Keyboard-PCB-Replica-Project/Cloudnine_rp2040/Cloudnine_rp2040.step

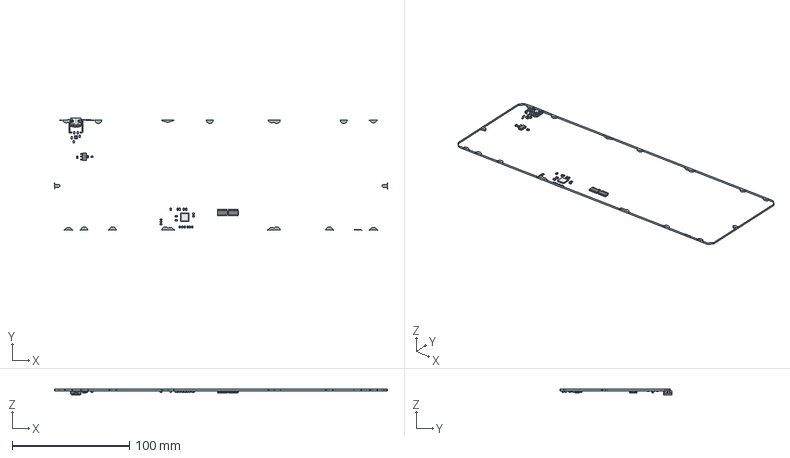
[picture p1: CAD file, 2025-07-11]
Cloudnine_rp2040.step
284.3 x 95.7 x 4.96 mm
R_0805_2012Metric x 8
C_0805_2012Metric x 16
SOIC_14_39x87mm_P127mm x 2
QFN-56-1EP_7x7mm_Pitch0.4mm
SOT_23_6
SOT_223
Fuse_0805_2012Metric
USB_C_Receptacle_16P_TopMnt_Horizontal_GCT_USB4105-xx-A
63_4_PCB
