Keyboard-PCB-Replica-Project/Cloudnine_rp2040/Cloudnine_rp2040.kicad_pcb

## KiCad design Cloudnine_rp2040.kicad_pcb (2026-01-03)

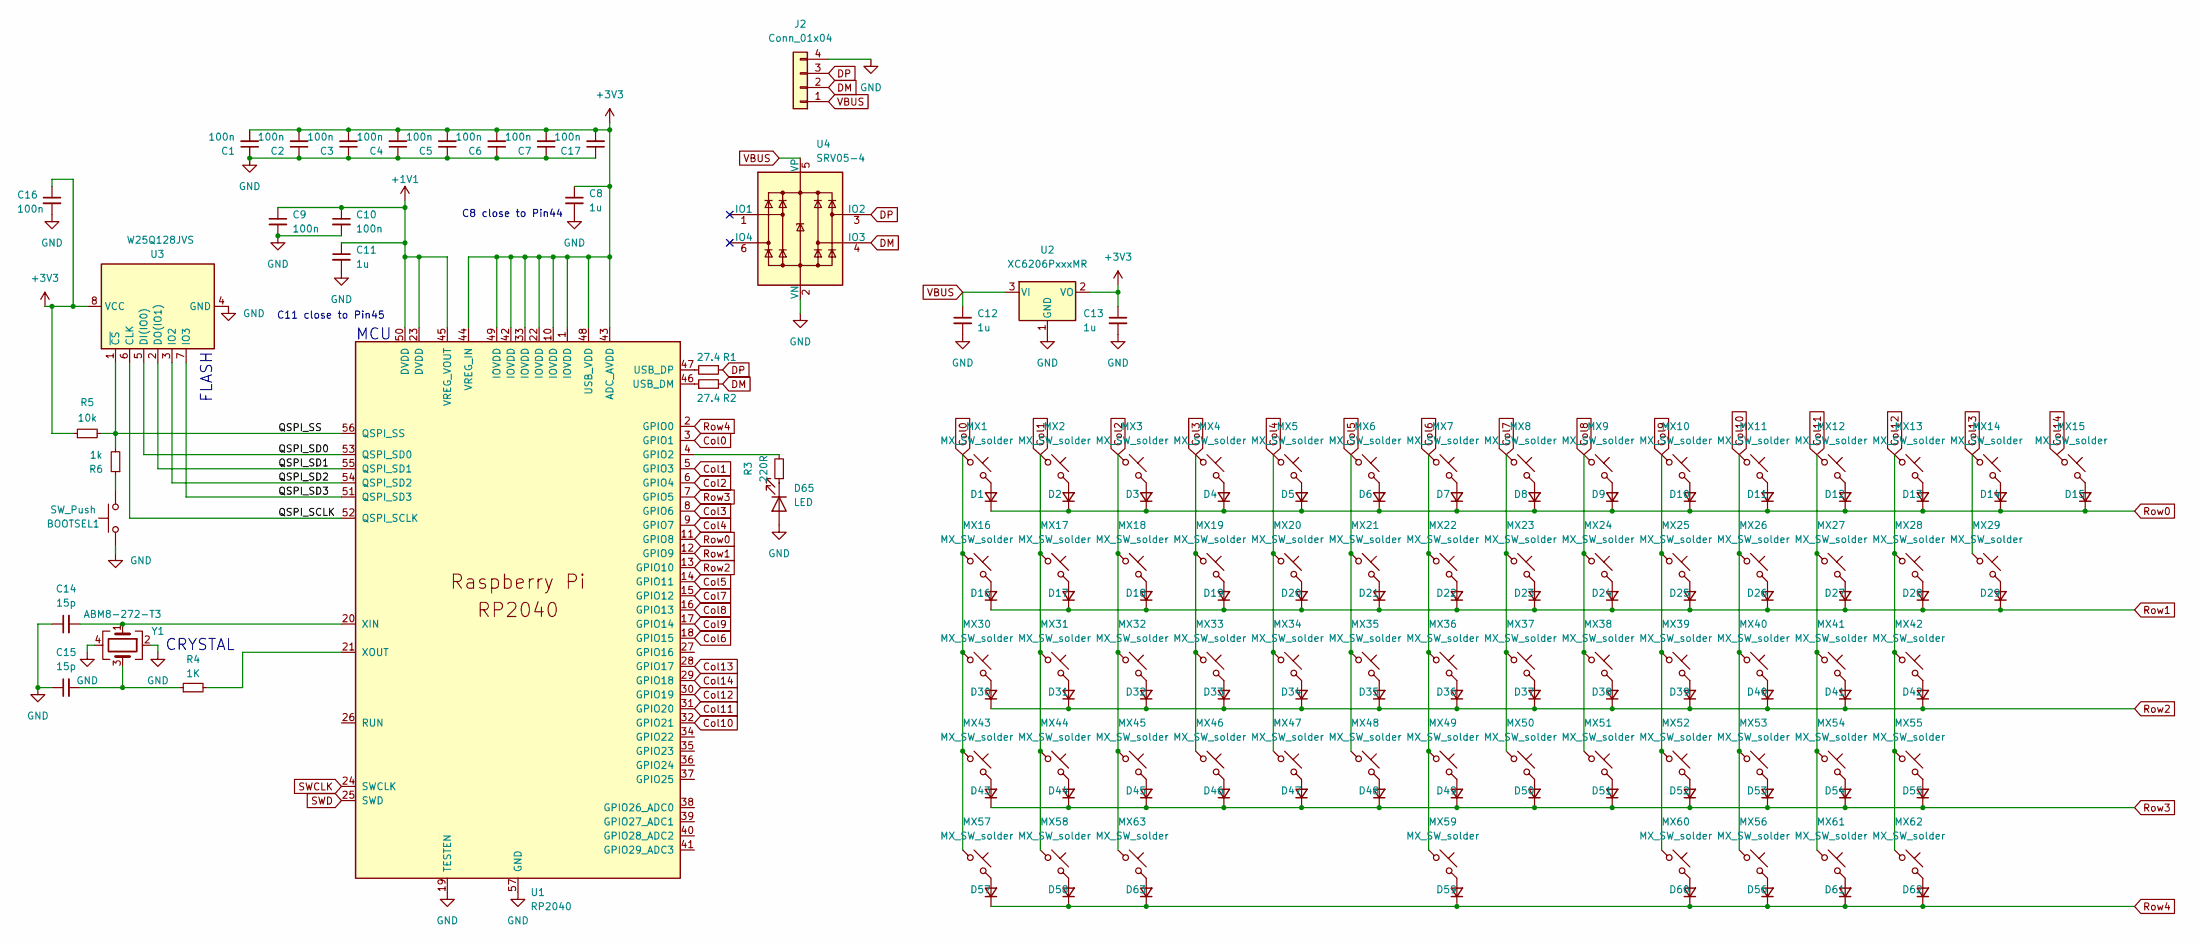
[picture p2: schematic Cloudnine_rp2040.kicad_sch]

Parts:
BOOTSEL1: SW_Push; SW_Push_1P1T_XKB_TS-1187A
C1, C2, C3, C4, C5, C6, C7, C9, C10, C16, C17: 100n; C_0402_1005Metric
C8, C11, C12, C13: 1u; C_0402_1005Metric
C14, C15: 15p; C_0402_1005Metric
D1, D2, D3, D4, D5, D6, D7, D8, D9, D10, D11, D12, D13, D14, D15, D16, D17, D18, D19, D20, D21, D22, D23, D24, D25, D26, D27, D28, D29, D30, D31, D32, D33, D34, D35, D36, D37, D38, D39, D40, D41, D42, D43, D44, D45, D46, D47, D48, D49, D50, D51, D52, D53, D54, D55, D56, D57, D58, D59, D60, D61, D62, D63: D_Small; Diode_SOD-123_noref2
D65: LED; cherry_ledhole
J2: Conn_01x04; JST_SH_SM04B-SRSS-TB_1x04-1MP_P1.00mm_Horizontal
MX1, MX2, MX3, MX4, MX5, MX6, MX7, MX8, MX9, MX10, MX11, MX12, MX13, MX14, MX15, MX16, MX17, MX18, MX19, MX20, MX21, MX22, MX23, MX24, MX25, MX26, MX27, MX28, MX29, MX30, MX31, MX32, MX33, MX34, MX35, MX36, MX37, MX38, MX39, MX40, MX41, MX42, MX43, MX44, MX45, MX46, MX47, MX48, MX49, MX50, MX51, MX52, MX53, MX54, MX55, MX56, MX57, MX58, MX59, MX60, MX61, MX62, MX63: MX_SW_solder; MX_PCB_1.00u_NoSilkscreen_narrow
R1, R2: 27.4; C_0603_1608Metric
R3: 220R; C_0402_1005Metric_noref
R4: 1K; C_0402_1005Metric
R5: 10k; C_0402_1005Metric
R6: 1k; C_0402_1005Metric
U1: RP2040; RP2040-QFN-56
U2: XC6206PxxxMR; SOT-23
U3: W25Q128JVS; SOIC-8_5.23x5.23mm_P1.27mm
U4: SRV05-4; SOT-23-6
Y1: ABM8-272-T3; Oscillator_SMD_EuroQuartz_XO32-4Pin_3.2x2.5mm

Connections:
+1V1: C9.1, C10.1, C11.1, U1.23 (DVDD), U1.45 (VREG_VOUT), U1.50 (DVDD)
+3V3: C1.2, C2.2, C3.2, C4.2, C5.2, C6.2, C7.2, C8.1, C13.1, C16.1, C17.2, R5.1, U1.1 (IOVDD), U1.10 (IOVDD), U1.22 (IOVDD), U1.33 (IOVDD), U1.42 (IOVDD), U1.43 (ADC_AVDD), U1.44 (VREG_IN), U1.48 (USB_VDD), U1.49 (IOVDD), U2.2 (VO), U3.8 (VCC)
/QSPI_SCLK: U1.52 (QSPI_SCLK), U3.6 (CLK)
/QSPI_SD0: U1.53 (QSPI_SD0), U3.5 (DI(IO0))
/QSPI_SD1: U1.55 (QSPI_SD1), U3.2 (DO(IO1))
/QSPI_SD2: U1.54 (QSPI_SD2), U3.3 (IO2)
/QSPI_SD3: U1.51 (QSPI_SD3), U3.7 (IO3)
/QSPI_SS: R5.2, R6.2, U1.56 (QSPI_SS), U3.1 (~CS)
Col0: MX1.1, MX16.1, MX30.1, MX43.1, MX57.1, U1.3 (GPIO1)
Col1: MX2.1, MX17.1, MX31.1, MX44.1, MX58.1, U1.5 (GPIO3)
Col2: MX3.1, MX18.1, MX32.1, MX45.1, MX63.1, U1.6 (GPIO4)
Col3: MX4.1, MX19.1, MX33.1, MX46.1, U1.8 (GPIO6)
Col4: MX5.1, MX20.1, MX34.1, MX47.1, U1.9 (GPIO7)
Col5: MX6.1, MX21.1, MX35.1, MX48.1, U1.14 (GPIO11)
Col6: MX7.1, MX22.1, MX36.1, MX49.1, MX59.1, U1.18 (GPIO15)
Col7: MX8.1, MX23.1, MX37.1, MX50.1, U1.15 (GPIO12)
Col8: MX9.1, MX24.1, MX38.1, MX51.1, U1.16 (GPIO13)
Col9: MX10.1, MX25.1, MX39.1, MX52.1, MX60.1, U1.17 (GPIO14)
Col10: MX11.1, MX26.1, MX40.1, MX53.1, MX56.1, U1.32 (GPIO21)
Col11: MX12.1, MX27.1, MX41.1, MX54.1, MX61.1, U1.31 (GPIO20)
Col12: MX13.1, MX28.1, MX42.1, MX55.1, MX62.1, U1.30 (GPIO19)
Col13: MX14.1, MX29.1, U1.28 (GPIO17)
Col14: MX15.1, U1.29 (GPIO18)
DM: J2.2, R2.2, U4.4 (IO3)
DP: J2.3, R1.1, U4.3 (IO2)
GND: BOOTSEL1.1, C1.1, C2.1, C3.1, C4.1, C5.1, C6.1, C7.1, C8.2, C9.2, C10.2, C11.2, C12.2, C13.2, C14.1, C15.1, C16.2, C17.1, D65.2 (A), J2.4, U1.19 (TESTEN), U1.57 (GND), U2.1 (GND), U3.4 (GND), U4.2 (VN), Y1.2, Y1.4
unnamed: BOOTSEL1.2, R6.1
unnamed: C15.2, R4.1, Y1.3
unnamed: D1.2 (A), MX1.2
unnamed: D2.2 (A), MX2.2
unnamed: D3.2 (A), MX3.2
unnamed: D4.2 (A), MX4.2
unnamed: D5.2 (A), MX5.2
unnamed: D6.2 (A), MX6.2
unnamed: D7.2 (A), MX7.2
unnamed: D8.2 (A), MX8.2
unnamed: D9.2 (A), MX9.2
unnamed: D10.2 (A), MX10.2
unnamed: D11.2 (A), MX11.2
unnamed: D12.2 (A), MX12.2
unnamed: D13.2 (A), MX13.2
unnamed: D14.2 (A), MX14.2
unnamed: D15.2 (A), MX15.2
unnamed: D16.2 (A), MX16.2
unnamed: D17.2 (A), MX17.2
unnamed: D18.2 (A), MX18.2
unnamed: D19.2 (A), MX19.2
unnamed: D20.2 (A), MX20.2
unnamed: D21.2 (A), MX21.2
unnamed: D22.2 (A), MX22.2
unnamed: D23.2 (A), MX23.2
unnamed: D24.2 (A), MX24.2
unnamed: D25.2 (A), MX25.2
unnamed: D26.2 (A), MX26.2
unnamed: D27.2 (A), MX27.2
unnamed: D28.2 (A), MX28.2
unnamed: D29.2 (A), MX29.2
unnamed: D30.2 (A), MX30.2
unnamed: D31.2 (A), MX31.2
unnamed: D32.2 (A), MX32.2
unnamed: D33.2 (A), MX33.2
unnamed: D34.2 (A), MX34.2
unnamed: D35.2 (A), MX35.2
unnamed: D36.2 (A), MX36.2
unnamed: D37.2 (A), MX37.2
unnamed: D38.2 (A), MX38.2
unnamed: D39.2 (A), MX39.2
unnamed: D40.2 (A), MX40.2
unnamed: D41.2 (A), MX41.2
unnamed: D42.2 (A), MX42.2
unnamed: D43.2 (A), MX43.2
unnamed: D44.2 (A), MX44.2
unnamed: D45.2 (A), MX45.2
unnamed: D46.2 (A), MX46.2
unnamed: D47.2 (A), MX47.2
unnamed: D48.2 (A), MX48.2
unnamed: D49.2 (A), MX49.2
unnamed: D50.2 (A), MX50.2
unnamed: D51.2 (A), MX51.2
unnamed: D52.2 (A), MX52.2
unnamed: D53.2 (A), MX53.2
unnamed: D54.2 (A), MX54.2
unnamed: D55.2 (A), MX55.2
unnamed: D56.2 (A), MX56.2
unnamed: D57.2 (A), MX57.2
unnamed: D58.2 (A), MX58.2
unnamed: D59.2 (A), MX59.2
unnamed: D60.2 (A), MX60.2
unnamed: D61.2 (A), MX61.2
unnamed: D62.2 (A), MX62.2
unnamed: D63.2 (A), MX63.2
unnamed: D65.1 (K), R3.1
unnamed: R3.2, U1.4 (GPIO2)
unnamed: R2.1, U1.46 (USB_DM)
unnamed: R1.2, U1.47 (USB_DP)
unnamed: C14.2, U1.20 (XIN), Y1.1
unnamed: R4.2, U1.21 (XOUT)
Row0: D1.1 (K), D2.1 (K), D3.1 (K), D4.1 (K), D5.1 (K), D6.1 (K), D7.1 (K), D8.1 (K), D9.1 (K), D10.1 (K), D11.1 (K), D12.1 (K), D13.1 (K), D14.1 (K), D15.1 (K), U1.11 (GPIO8)
Row1: D16.1 (K), D17.1 (K), D18.1 (K), D19.1 (K), D20.1 (K), D21.1 (K), D22.1 (K), D23.1 (K), D24.1 (K), D25.1 (K), D26.1 (K), D27.1 (K), D28.1 (K), D29.1 (K), U1.12 (GPIO9)
Row2: D30.1 (K), D31.1 (K), D32.1 (K), D33.1 (K), D34.1 (K), D35.1 (K), D36.1 (K), D37.1 (K), D38.1 (K), D39.1 (K), D40.1 (K), D41.1 (K), D42.1 (K), U1.13 (GPIO10)
Row3: D43.1 (K), D44.1 (K), D45.1 (K), D46.1 (K), D47.1 (K), D48.1 (K), D49.1 (K), D50.1 (K), D51.1 (K), D52.1 (K), D53.1 (K), D54.1 (K), D55.1 (K), U1.7 (GPIO5)
Row4: D56.1 (K), D57.1 (K), D58.1 (K), D59.1 (K), D60.1 (K), D61.1 (K), D62.1 (K), D63.1 (K), U1.2 (GPIO0)
SWCLK: U1.24 (SWCLK)
SWD: U1.25 (SWD)
VBUS: C12.1, J2.1, U2.3 (VI), U4.5 (VP)

Notes on the sheet:
C11 close to Pin45
MCU
CRYSTAL
C8 close to Pin44
FLASH

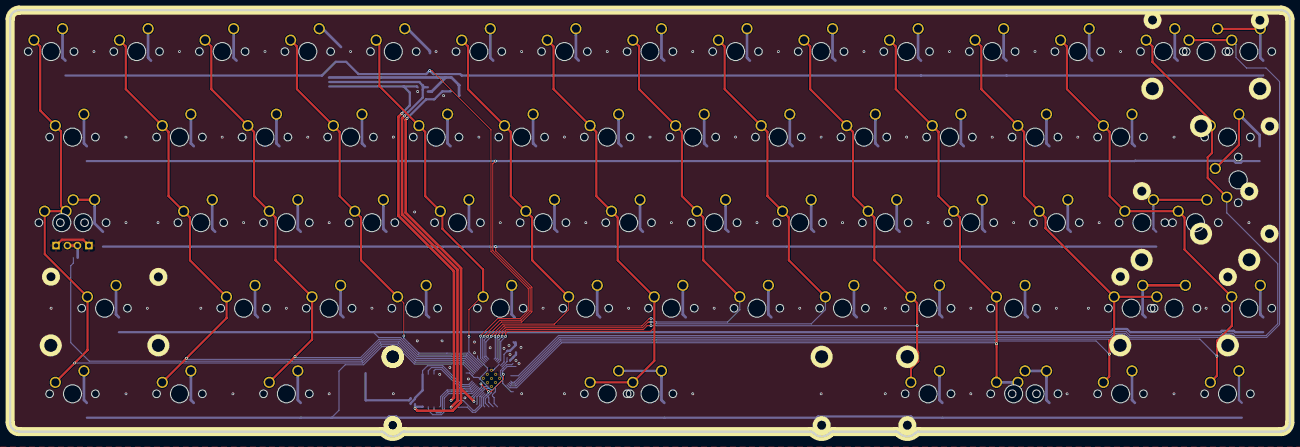
[picture p3: board Cloudnine_rp2040.kicad_pcb from above]

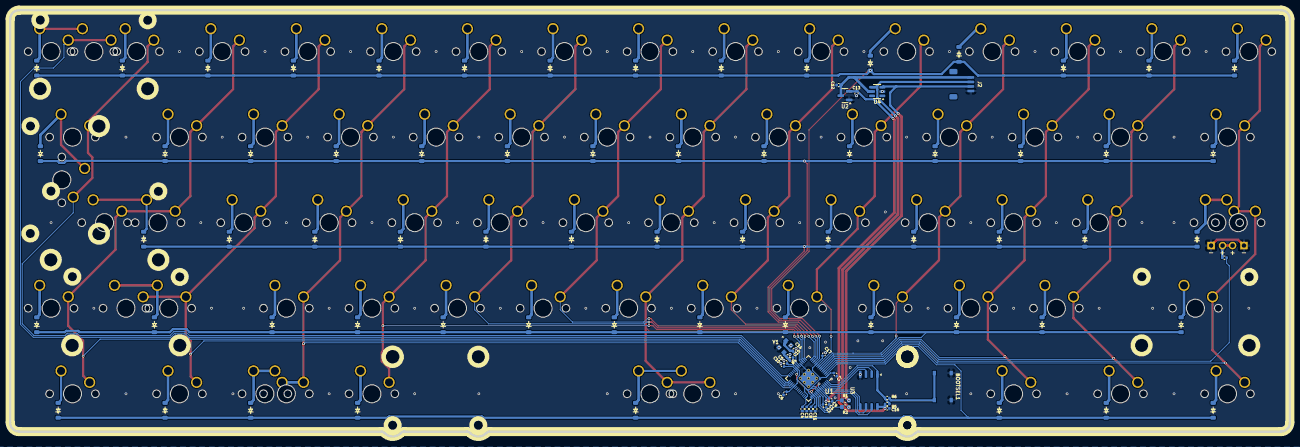
[picture p4: board Cloudnine_rp2040.kicad_pcb from below]

Board: 2 copper layers, 284.2 x 94.7 mm, 157 parts (93 on the bottom side), 103 nets.
